niedi74/VDO-Tempomat-/README.md

# VDO-Tempomat-
leagcy unit connected to CAN
controll over Touch dispaly
