niedi74/VDO-Tempomat-/docs/images/bedienteil/innen-1.jpg

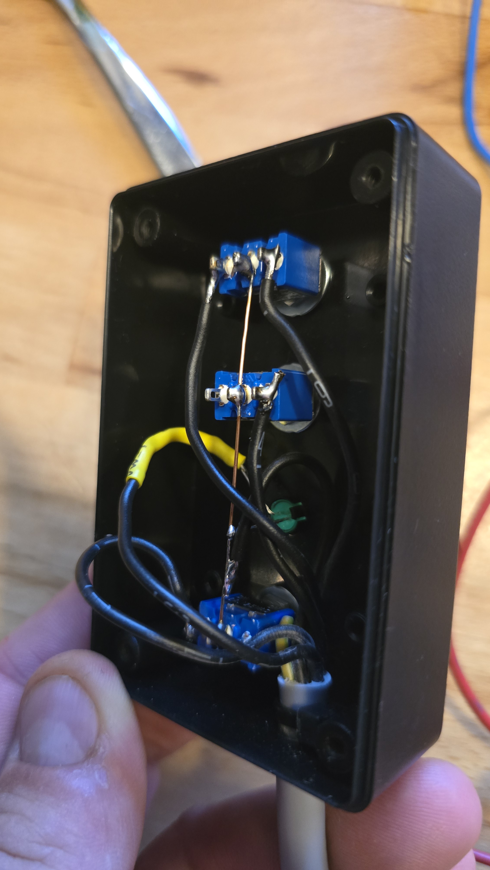
docs/images/bedienteil/innen-1.jpg
