niedi74/VDO-Tempomat-/docs/images/bedienteil/innen-2.jpg

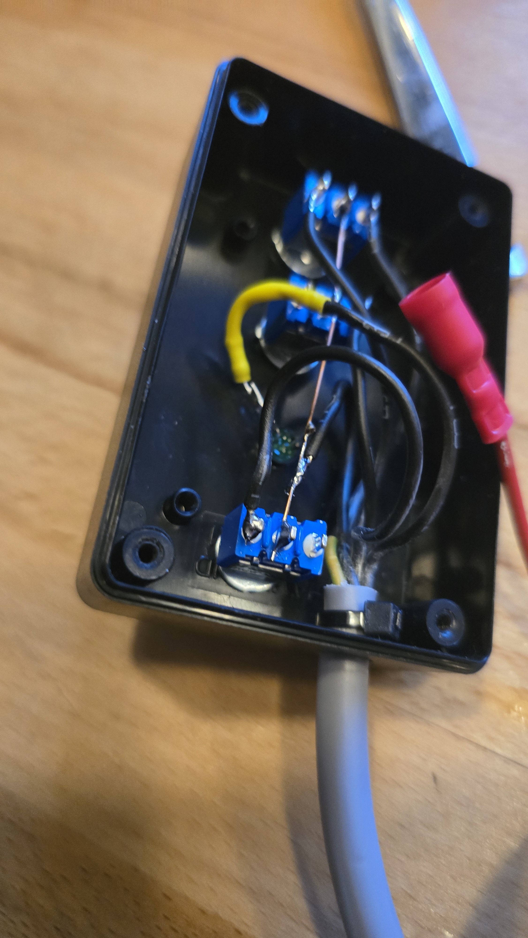
docs/images/bedienteil/innen-2.jpg
