niedi74/VDO-Tempomat-/docs/images/bedienteil/innen-3.jpg

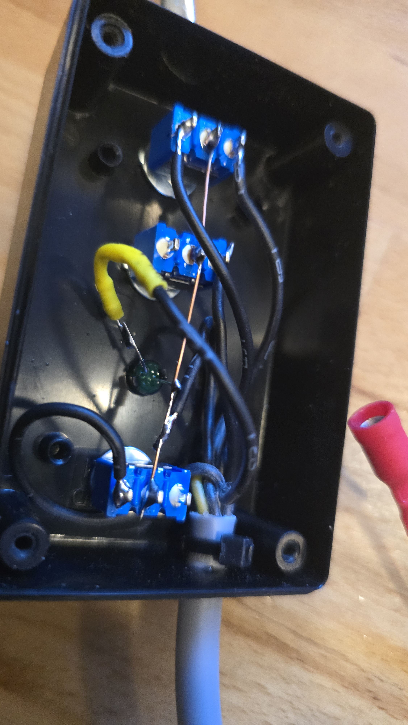
docs/images/bedienteil/innen-3.jpg
