niedi74/VDO-Tempomat-/docs/images/bedienteil/innen-4.jpg

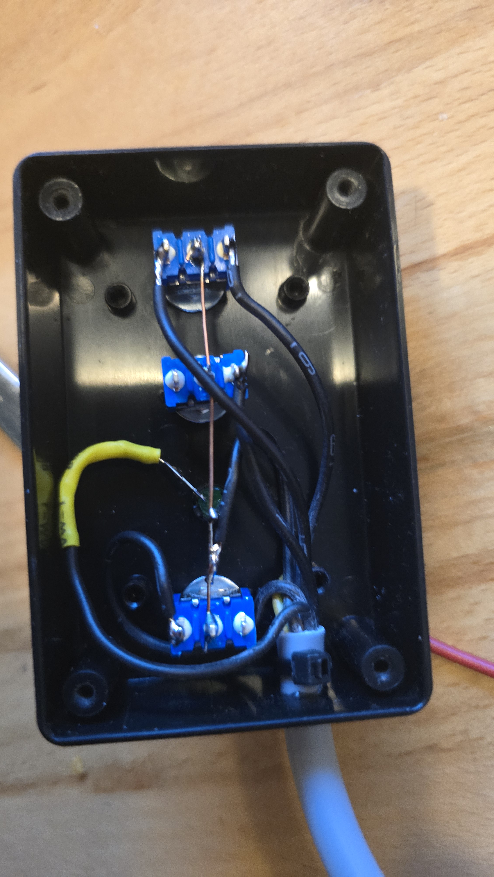
docs/images/bedienteil/innen-4.jpg
