niedi74/VDO-Tempomat-/docs/images/bedienteil/innen-uebersicht.jpg

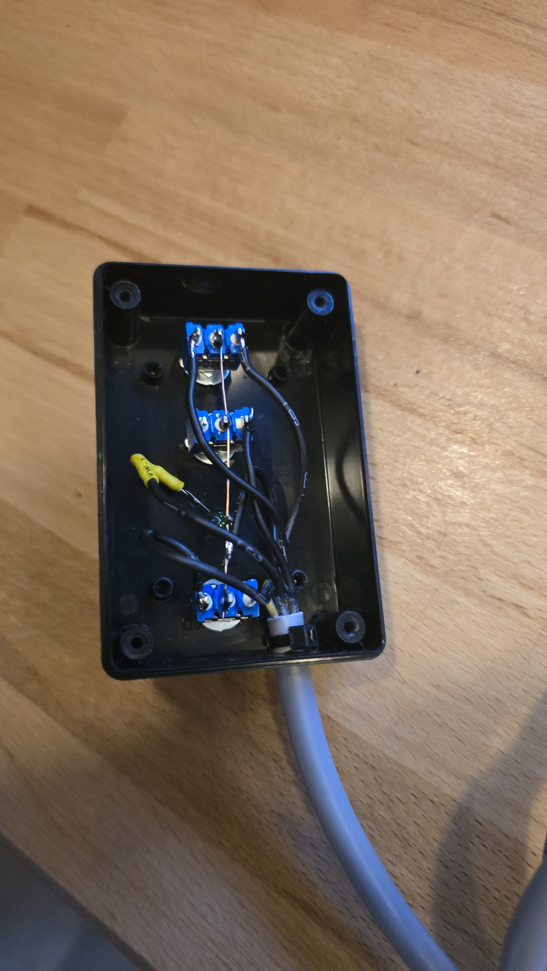
docs/images/bedienteil/innen-uebersicht.jpg
