niedi74/VDO-Tempomat-/docs/images/esp32/terminal-adapter-esp32-s3-44p.jpg

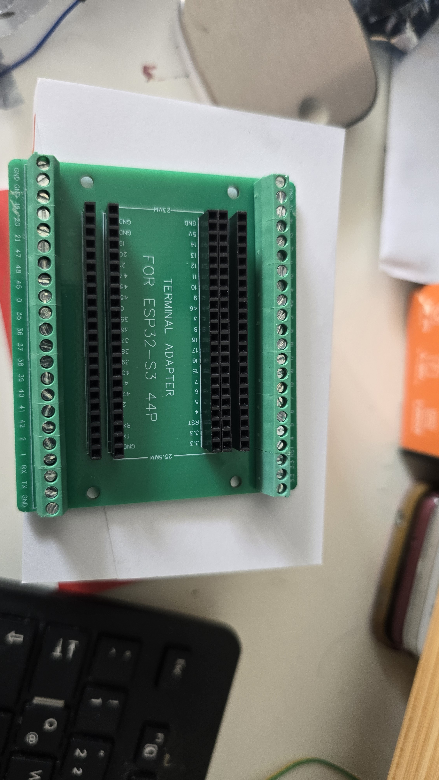
docs/images/esp32/terminal-adapter-esp32-s3-44p.jpg
