niedi74/VDO-Tempomat-/docs/images/handbuch/02-komponenten-stg-g-p.jpg

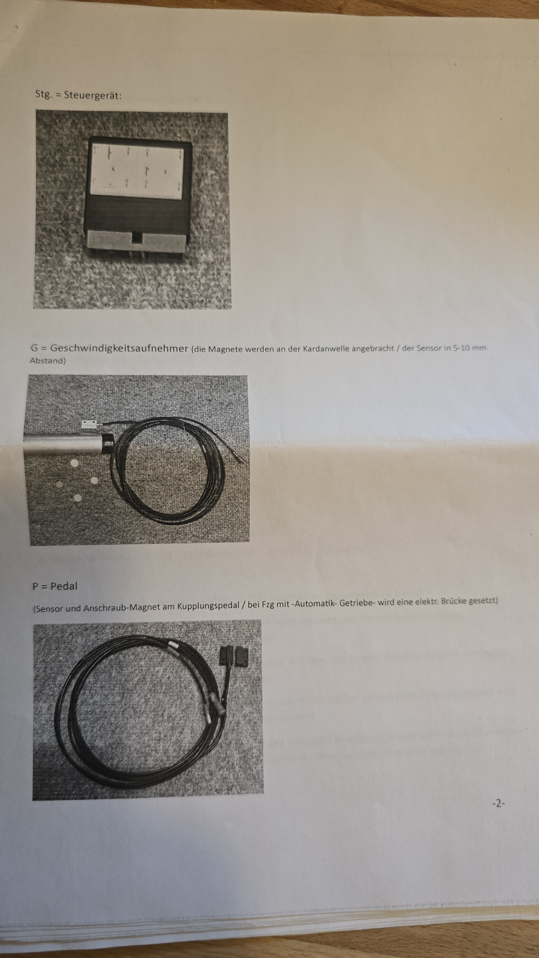
docs/images/handbuch/02-komponenten-stg-g-p.jpg
