niedi74/VDO-Tempomat-/docs/images/handbuch/03-bedienteil-funktionen.jpg

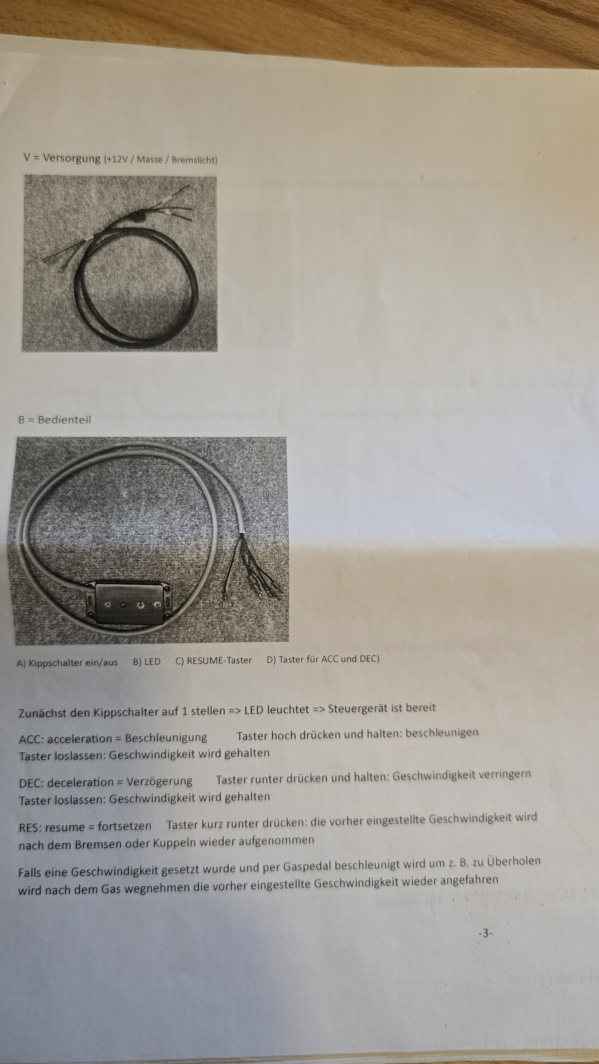
docs/images/handbuch/03-bedienteil-funktionen.jpg
