niedi74/VDO-Tempomat-/docs/images/handbuch/04-motorpumpe-unterdruckdose.jpg

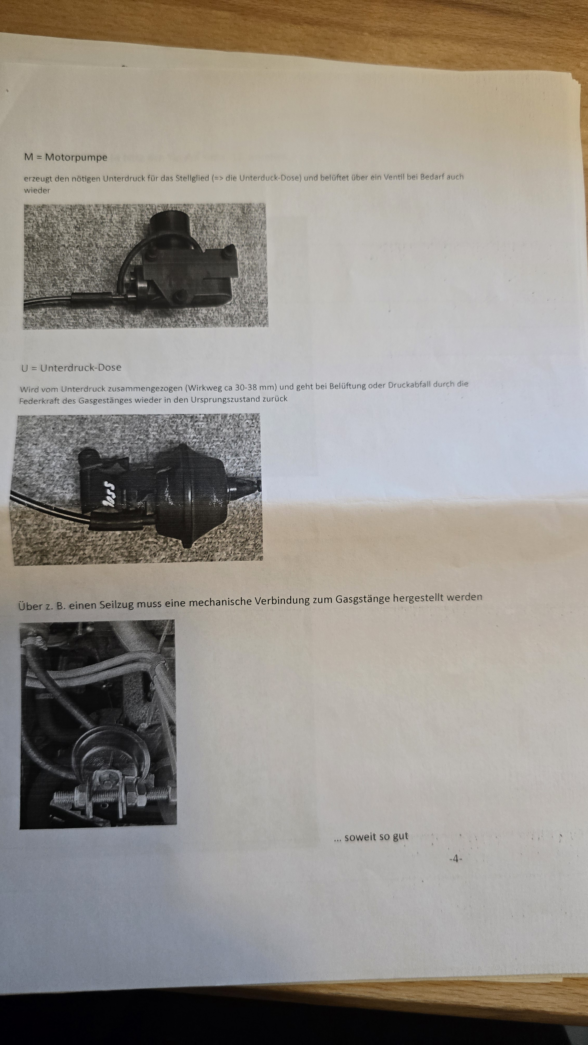
docs/images/handbuch/04-motorpumpe-unterdruckdose.jpg
