niedi74/VDO-Tempomat-/docs/images/handbuch/05-verdrahtungsplan.jpg

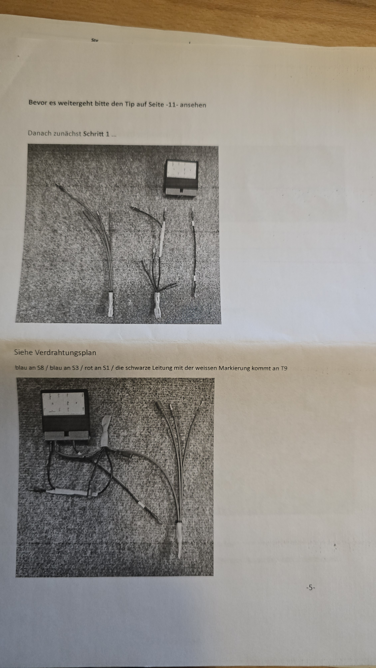
docs/images/handbuch/05-verdrahtungsplan.jpg
