niedi74/VDO-Tempomat-/docs/images/handbuch/06-schritt2-sensor.jpg

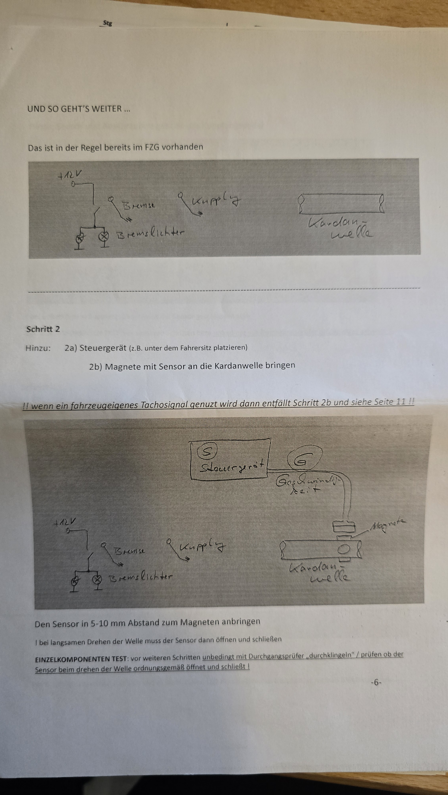
docs/images/handbuch/06-schritt2-sensor.jpg
