niedi74/VDO-Tempomat-/docs/images/handbuch/07-schritt3-4-kupplung-versorgung.jpg

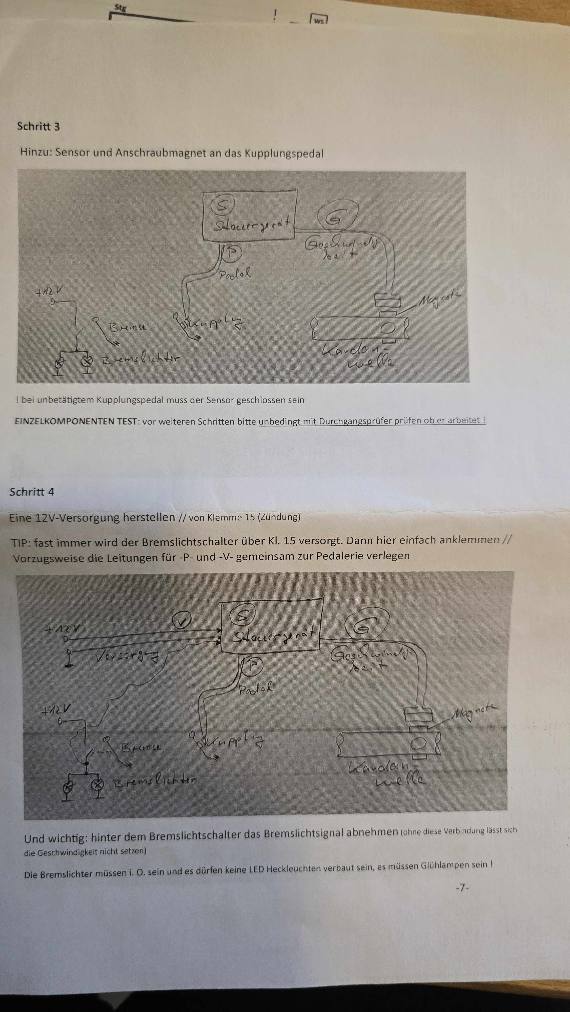
docs/images/handbuch/07-schritt3-4-kupplung-versorgung.jpg
