niedi74/VDO-Tempomat-/docs/images/handbuch/08-schritt5-6-bedienteil-motorpumpe.jpg

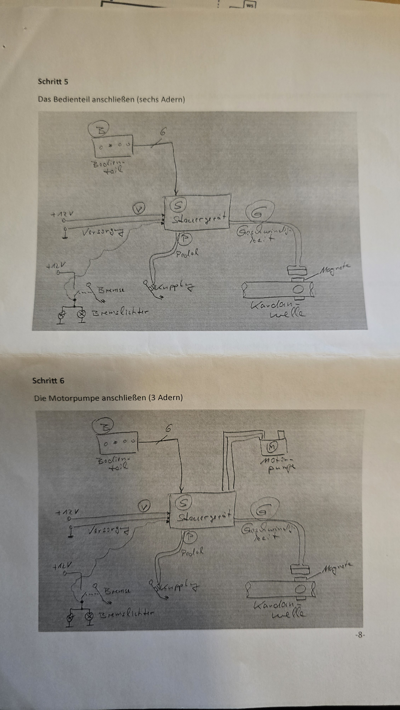
docs/images/handbuch/08-schritt5-6-bedienteil-motorpumpe.jpg
