niedi74/VDO-Tempomat-/docs/images/handbuch/10-bedienung.jpg

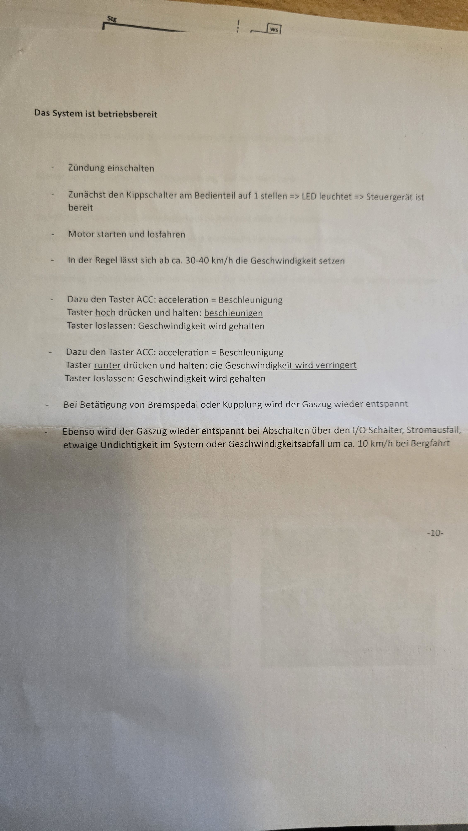
docs/images/handbuch/10-bedienung.jpg
