niedi74/VDO-Tempomat-/docs/images/handbuch/11-tip-trockenuebung.jpg

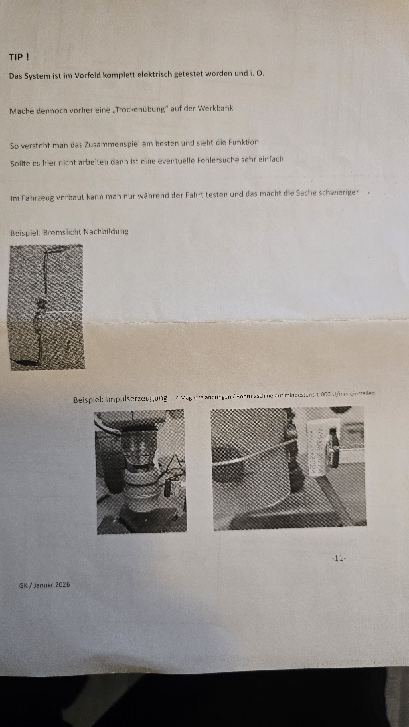
docs/images/handbuch/11-tip-trockenuebung.jpg
