niedi74/VDO-Tempomat-/docs/images/handbuch/12-schaltplan.jpg

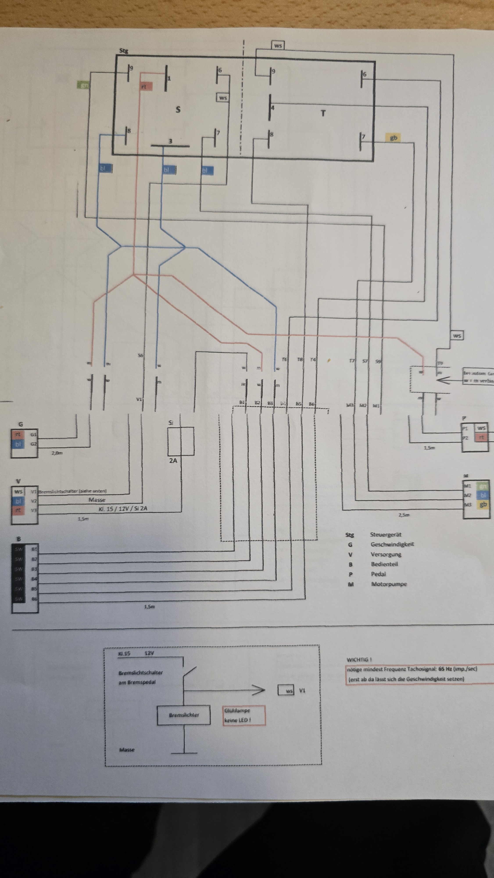
docs/images/handbuch/12-schaltplan.jpg
