niedi74/VDO-Tempomat-/docs/images/schaltplan-detail-1.jpg

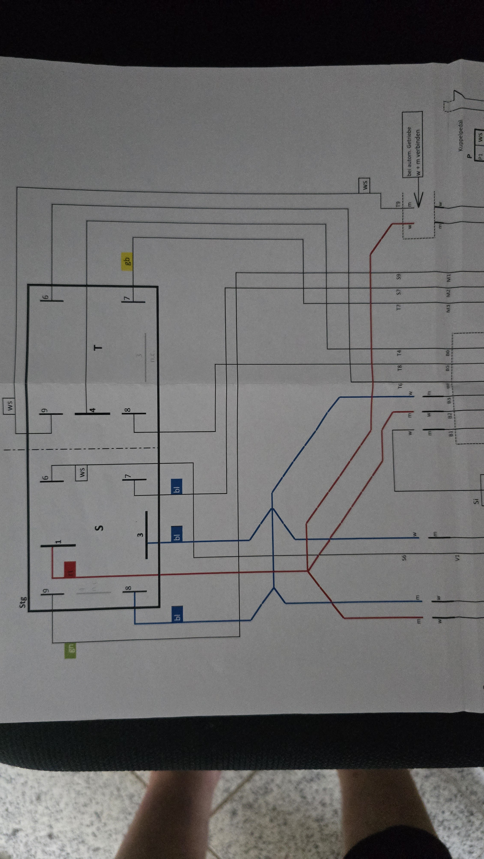
docs/images/schaltplan-detail-1.jpg
