niedi74/VDO-Tempomat-/docs/images/schaltplan-detail-2.jpg

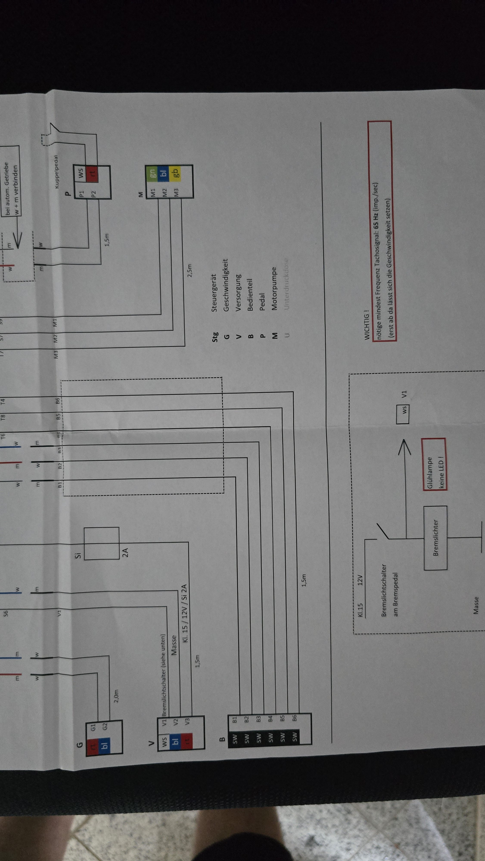
docs/images/schaltplan-detail-2.jpg
