niedi74/VDO-Tempomat-/docs/images/schaltplan-detail-b-stecker.jpg

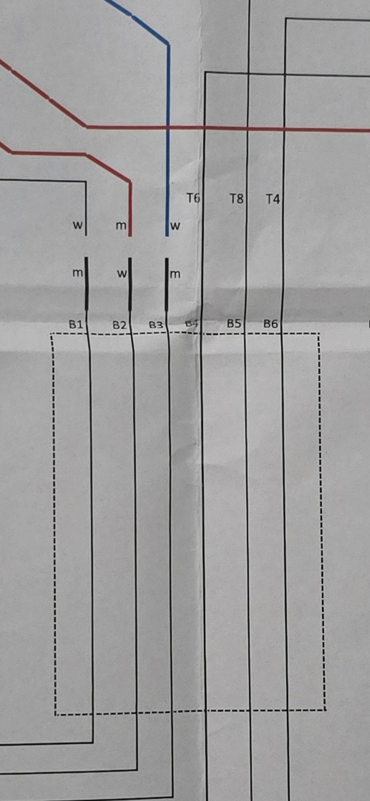
docs/images/schaltplan-detail-b-stecker.jpg
