niedi74/VDO-Tempomat-/docs/images/schaltplan-detail-g-v-reed.jpg

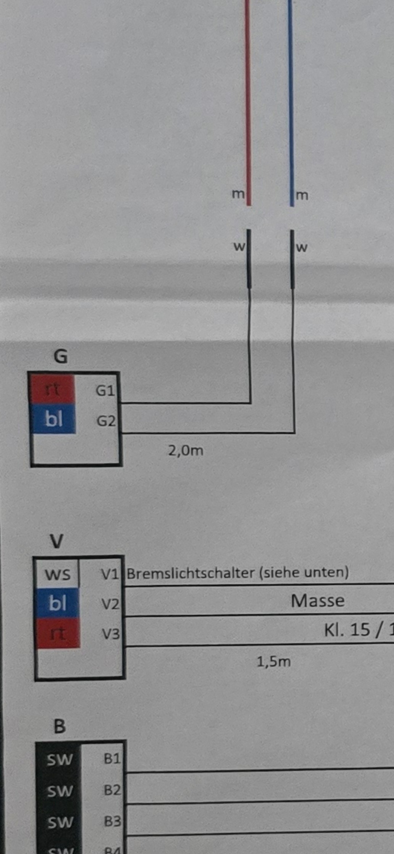
docs/images/schaltplan-detail-g-v-reed.jpg
