niedi74/VDO-Tempomat-/docs/images/schaltplan-detail-legende.jpg

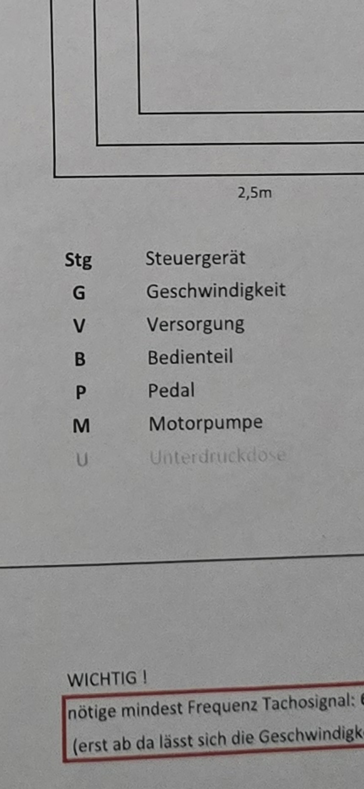
docs/images/schaltplan-detail-legende.jpg
