niedi74/VDO-Tempomat-/docs/images/schaltplan-komplett-klar.jpg

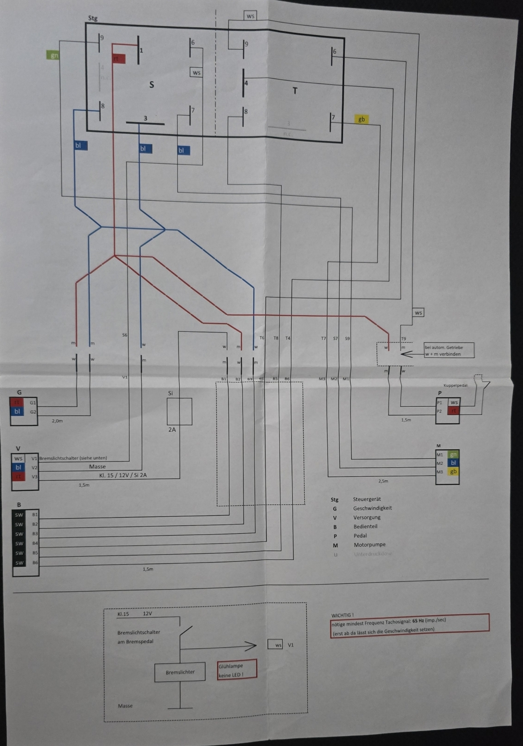
docs/images/schaltplan-komplett-klar.jpg
