niedi74/VDO-Tempomat-/docs/images/schaltplan-stecker-g-v-b.jpg

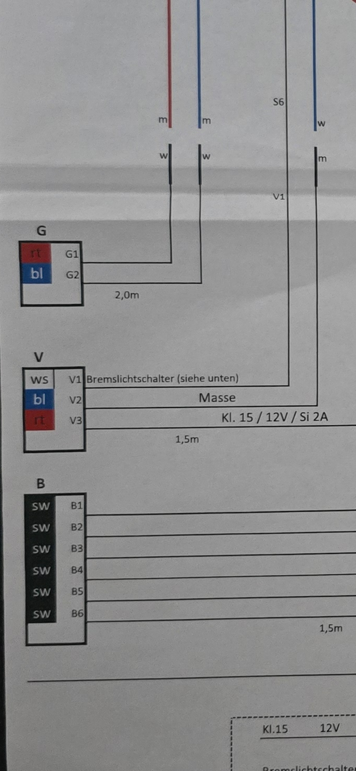
docs/images/schaltplan-stecker-g-v-b.jpg
