niedi74/VDO-Tempomat-/docs/images/handbuch/09-schritt7-8-test-unterdruckdose.jpg

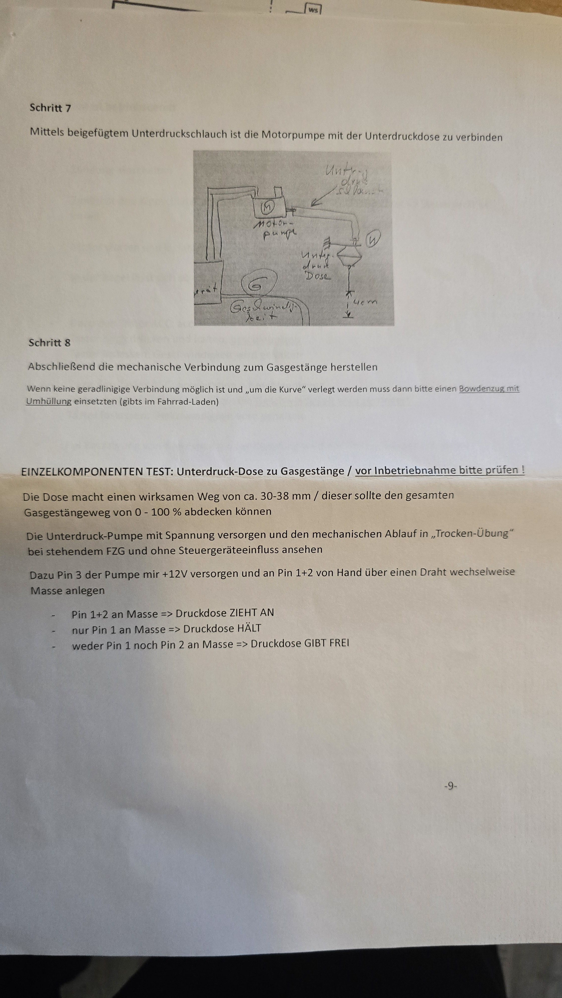
docs/images/handbuch/09-schritt7-8-test-unterdruckdose.jpg
