niedi74/VDO-Tempomat-/(commit log)

2026-06-25 docs: Hardware-Fotos und Beschreibung des VDO-Tempomat ergänzen
    Claude-Session: https://claude.ai/code/session_019hhT4rrVsqyD9aWQ2wqNbN
2026-06-28 docs: Schaltplan hinzufügen und Pinbelegung entschlüsseln
    - Schaltplan-Fotos gesichert
    - Legende, Stecker G/V/B/P/M, Bremssignal, Speed-Signal dokumentiert
    - Bremse V1 = active high (+12V), Gluehlampe Pflicht (keine LED)
    - min. 65 Hz Tachosignal
    - Stellglied = Motorpumpe (elektrisch), Unterdruckdose ungenutzt
    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
2026-06-28 docs: Original-Handbuch (16 Fotos) + Erkenntnisse ergaenzen
    - Alle Handbuchseiten + Einbaufotos im Repo gesichert
    - handbuch.md: Komponenten, Bedienteil-Funktionen (A/B/C/D), Einbauschritte
    - Motorpumpe Pin-Test (Pin3=+12V, Pin1+2 Masse=zieht an/haelt/frei)
    - Reed-Sensor Typ WEDER WG04-1A66B-500W S2/2, min 65 Hz
    - Korrektur: Motorpumpe UND Unterdruckdose werden benutzt (U nur pneumatisch)
    - schaltplan.md entsprechend aktualisiert
    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
2026-06-28 docs: Bedienteil-Verdrahtung (Eigenbau) + ESP-Anbindung
    - 6 Bedienteil-Fotos gesichert
    - Adernbelegung 1-6 (ein/aus, Masse, LED, RESUME, ACC, DEC)
    - geschaltete Masse bestaetigt -> normale Optokoppler genuegen (kein PhotoMOS)
    - ESP paralleliert direkt an den 6 Adern (S/T-Mapping nicht noetig)
    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
2026-06-29 docs: Korrektur - Rot=12V Verteilerschiene (nicht Reed), Automatik T9->Kl.9
    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
2026-06-29 docs: ESP32-S3 44P Pinbelegung der Inline-Box
    - Ausgaenge RESUME/ACC/DEC (GPIO5/6/7) -> Relais parallel zu Tastern
    - Eingaenge Speed(GPIO4)/Bremse(GPIO15)/LED(GPIO16) ueber Optokoppler
    - CAN TWAI TX/RX (GPIO17/18) fuer Touch-Display
    - nur sichere GPIOs (keine Boot/USB/Flash-Pins), Versorgung + Sicherheitsregeln
    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
2026-06-29 docs: CAN/Netz-Konventionen aus spartan3v2-can-adapter uebernommen
    - CAN 500 kbit/s, 11-bit, SN65HVD230; 0x400 (Spartan) belegt
    - Tempomat-IDs Vorschlag 0x420/0x421 (gegen ID-Map zu bestaetigen)
    - Framework Arduino-ESP32 (PlatformIO) wie Spartan; ESP-NOW/BLE optional
    - AP-IP fix 192.168.6.1 (Spartan nutzt 192.168.4.1)
    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
2026-06-29 docs: On/Off implizit (Schalter versorgt ESP), GUI nur Devboard-Setup + Tempomat-Live-Page
    - kein Software-On/Off: physischer Schalter gibt ESP erst Strom
    - ESP-Versorgung vom EIN/AUS-geschalteten 12V-Strang (kein Dauerplus -> Config in NVS)
    - Web-GUI: nur Devboard-/Setup-Geruest vom Spartan, Live = Tempomat-Page
    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
2026-06-29 docs: ESP32-S3 Pinbelegung finalisiert (Master-Tabelle)
    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
2026-06-29 docs: Verkabelungsplan ESP-Box + Stromversorgung final = rohes Kl.15 (ESP immer an bei Zuendung)
    - neue docs/verkabelung-esp.md (ASCII-Schema + Anschlusslisten: Power/Relais/Opto/CAN)
    - Entscheidung: ESP-Versorgung von rohem Kl.15 -> laeuft immer bei Zuendung
    - On/Off NICHT mehr ueber Strom, sondern Erkennung am LED-Signal (GPIO16)
    - esp32-pinbelegung.md und software-konzept.md entsprechend korrigiert
    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
2026-06-29 docs: B1-B6 VDO-Klemmen im 6-Adern-Schaltbild eingetragen (+ S/T-Mapping der Tasten)
    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
2026-06-29 docs: PC817-Opto-Modul Pinout (INPUT +/-, OUTPUT VCC/OUT/GND), active-low
    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
2026-06-29 docs: Modul-Zuordnung & Stueckzahl (3 MOSFET Ausgaenge, 2-3 Opto Eingaenge) + AMS1117-Warnung
    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
2026-06-29 docs: Reed kommt vom Spartan-Hub (kein lokaler Reed, GPIO4 frei); Opto = EL817 12V, nur 2 noetig
    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
2026-06-29 docs: Gesamtschaltplan-Bild (alle Pins/Anschluesse: B1-B6, MOSFET, Opto, Buck, CAN)
    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
2026-06-29 docs: Abschnitt 2 - MOSFET als gewaehlter Weg klargestellt (Relais = Alternative)
    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
2026-07-01 docs: MOSFET-Modul exakte Klemmen (VIN+/VIN-/OUT-/TRIG/GND) + Anschlussbild
    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
2026-07-01 docs: MOSFET-Anschlussbild um TRIG/PWM-Erklaerung + J1-Stiftleiste ergaenzt
    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
2026-07-01 docs: Roadmap (Prototyp mit Modulen -> Custom-PCB assembliert/PCBA, kein Loeten)
    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
2026-07-01 docs: Bestell-Paket fuer Custom-PCB (Schaltplan/BOM/Netzliste/EasyEDA-PCBA) in Roadmap ergaenzt
    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
2026-07-06 docs: Konzept-Review (4 Schleifen) + Konsistenz-Fixes
    - review.md: Sicherheit (klemmender ACC, Boot-Glitches, API-Schutz),
    Elektrik (Reed-Abgriff-Last, Frequenz-Mathe), Software (Stale-Guard,
    OTA, ehrliche Soll-Anzeige), Perspektiven (Limiter, Nudge, Selbsttest,
    Logging, GPS, HW-Sicherheitsstufe) + priorisierte Merkliste
    - Relais->MOSFET in esp32-pinbelegung.md und software-konzept.md vereinheitlicht
    - MAX_PULSE_MS + Review-Punkte in Firmware-Spez uebernommen
    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
2026-07-11 docs: MC-38 als 2. Reed bestellt - Einbauhinweise (Magnetblock nicht an Welle, Abstand testen, versiegeln)
    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
2026-07-12 docs: Cat5e als Kabelbaum Kabine<->Unterboden (Bremse/Power/Impuls), Strombudget 450mA bestaetigt
2026-07-13 docs: Testplan ohne montierten Reed - elektronischer Reed-Simulator per freiem MOSFET-Kanal
2026-07-13 feat: Reed-Simulator Firmware fuer zweiten ESP32 (MOSFET-basiert)
    - firmware/reed-simulator/reed-simulator.ino: Serial-gesteuerter Rechteck-
    Generator (f<Hz>/v<km/h>/stop/sweep/status), startet sicher mit 0 Hz
    - README mit Verkabelung, Flash-Anleitung, Sicherheitshinweis
    - test-ohne-reed.md auf konkrete Firmware verwiesen statt Pseudocode
    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
2026-07-14 fix: Reed-Simulator fuer ESP32-S3 korrigiert (Board-Typ + sicherer GPIO8 statt GPIO25)
    - COM16-Board ist ESP32-S3 (Xtensa LX7), nicht klassischer ESP32
    - Arduino IDE Board: ESP32S3 Dev Module / FQBN esp32:esp32:esp32s3
    - PIN_OUT von GPIO25 auf GPIO8 (vermeidet Octal-PSRAM/Flash-Range 26-37)
    - Hinweis USB CDC On Boot fuer stummen Serial Monitor ergaenzt
    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
    [reed-simulator.ino]
2026-07-14 docs: Verifikations-Feedback vom lokalen Flash-Test einarbeiten
    - [S3-FIX]-Kommentar mit Fehlerbild ergaenzt (Historie fuer den GPIO25->8 Fix)
    - README: Troubleshooting-Tipp 'Invalid pin' -> Ausgang schaltet nie, kein
    offensichtlicher Laufzeitfehler
    - README: Vorlage-Hinweis fuer spaetere WiFi-Erweiterung (MAC-Override,
    statische IP) aus spartan3v2-can-adapter, kein Handlungsbedarf jetzt
    - GPIO8-Fix live am ESP32-S3-DevKitC-1 (COM16) durch lokalen Chat bestaetigt
    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
    [reed-simulator.ino]
